bolshoydrug1/Kvadro_CTRL_hw/(list of files, drawings)

Other design files:
freerouting.dsn
