bolshoydrug1/Kvadro_CTRL_hw/Magister_work_v1.kicad_pcb

## KiCad design Magister_work_v1.kicad_pcb (2026-08-19)

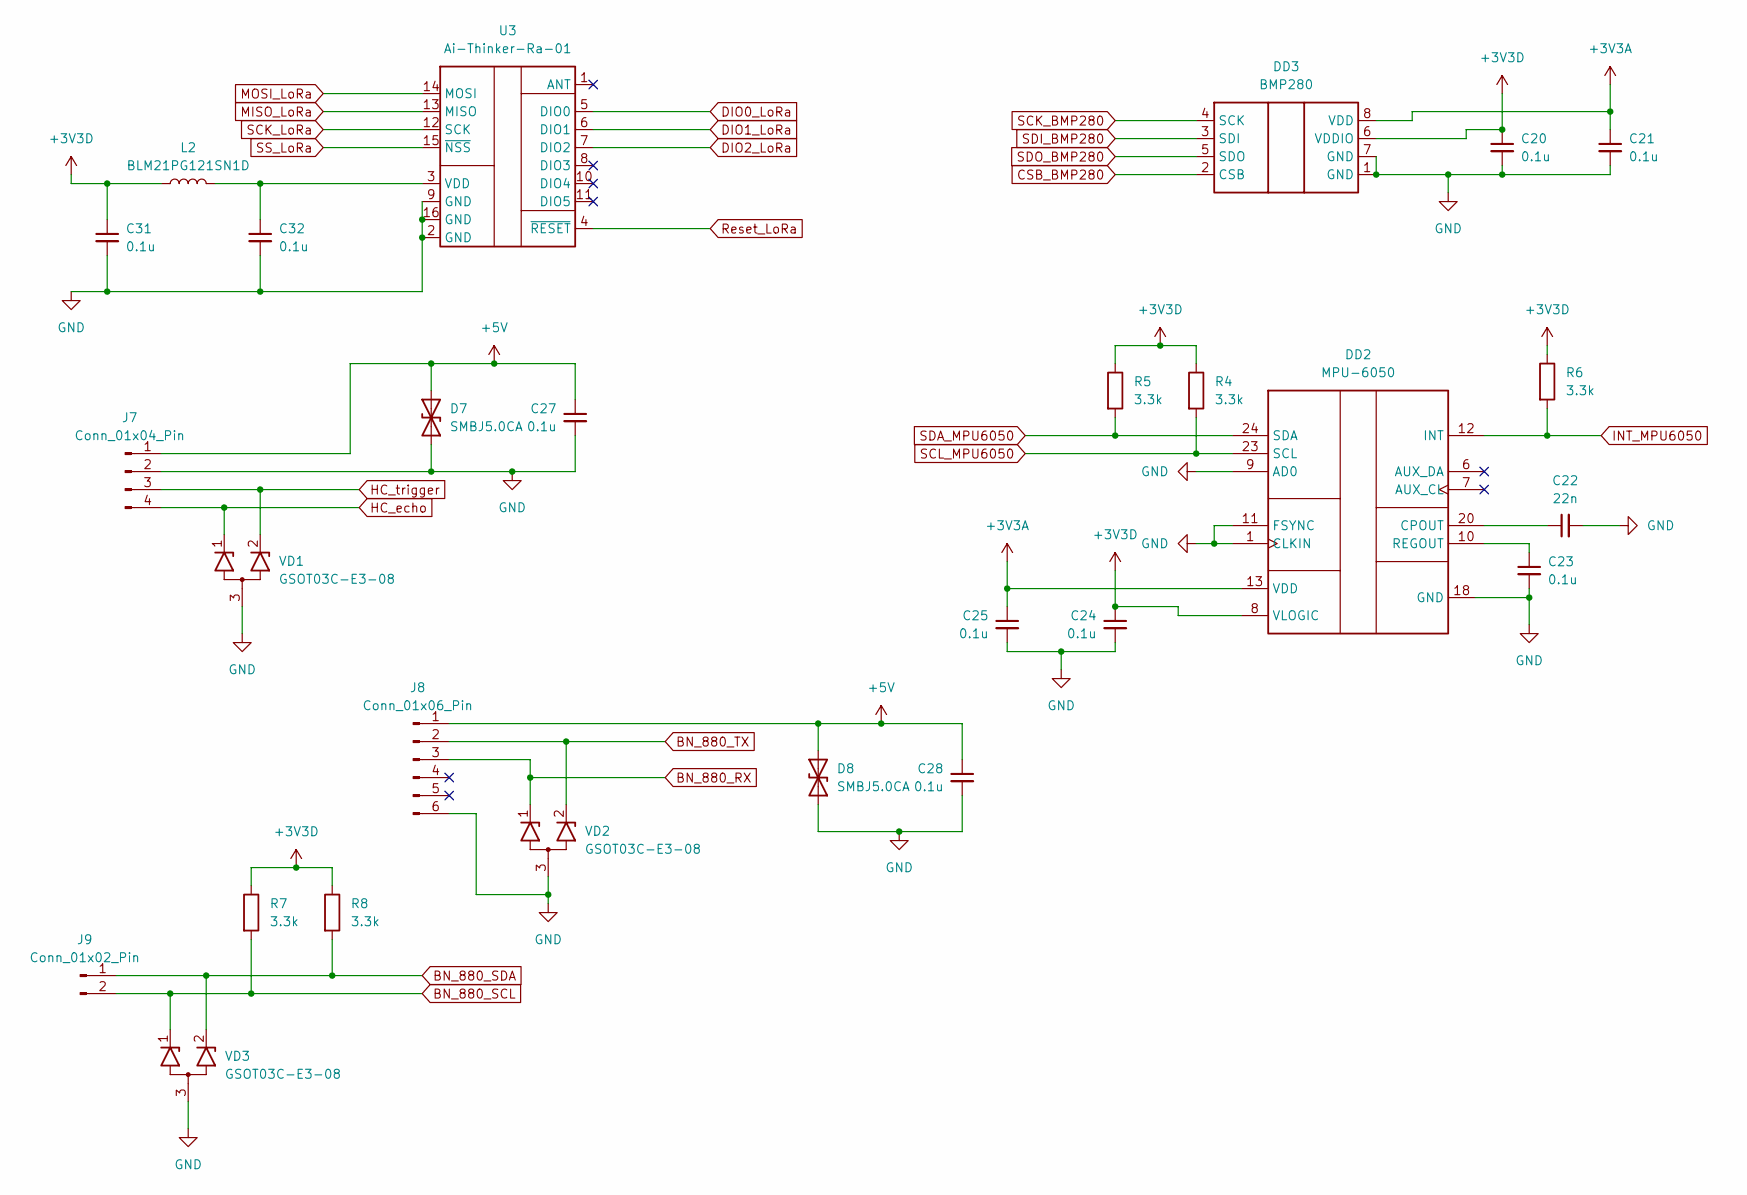
[picture p1: schematic Sensors_1.kicad_sch]

Parts:
C20, C21, C23, C24, C25, C27, C28, C31, C32: 0.1u; C_0805_2012Metric_Pad1.18x1.45mm_HandSolder
C22: 22n; C_0805_2012Metric_Pad1.18x1.45mm_HandSolder
D7, D8: SMBJ5.0CA; D_SMB_Handsoldering
DD2: MPU-6050; InvenSense_QFN-24_4x4mm_P0.5mm
DD3: BMP280; Bosch_LGA-8_2x2.5mm_P0.65mm_ClockwisePinNumbering
J7: Conn_01x04_Pin; PinHeader_1x04_P2.54mm_Horizontal
J8: Conn_01x06_Pin; Hirose_DF13-06P-1.25DSA_1x06_P1.25mm_Vertical
J9: Conn_01x02_Pin; Hirose_DF13-02P-1.25DSA_1x02_P1.25mm_Vertical
L2: BLM21PG121SN1D; L_0805_2012Metric_Pad1.05x1.20mm_HandSolder
R4, R5, R6, R7, R8: 3.3k; R_0805_2012Metric_Pad1.20x1.40mm_HandSolder
U3: Ai-Thinker-Ra-01; Ai-Thinker-Ra-01-LoRa
VD1, VD2, VD3: GSOT03C-E3-08; SOT-23_Handsoldering

Connections:
+3V3A: C21.1, C25.1, DD2.13 (VDD), DD3.8 (VDD); also elsewhere on the board
+3V3D: C20.1, C24.1, C31.1, DD2.8 (VLOGIC), DD3.6 (VDDIO), L2.1, R4.1, R5.1, R6.1, R7.1, R8.1; also elsewhere on the board
+5V: C27.1, C28.1, D7.2 (A2), D8.2 (A2), J7.1, J8.1; also elsewhere on the board
BN_880_RX: J8.3, VD2.1 (K1); also elsewhere on the board
BN_880_SCL: J9.2, R7.2, VD3.1 (K1); also elsewhere on the board
BN_880_SDA: J9.1, R8.2, VD3.2 (K2); also elsewhere on the board
BN_880_TX: J8.2, VD2.2 (K2); also elsewhere on the board
CSB_BMP280: DD3.2 (CSB); also elsewhere on the board
DIO0_LoRa: U3.5 (DIO0); also elsewhere on the board
DIO1_LoRa: U3.6 (DIO1); also elsewhere on the board
DIO2_LoRa: U3.7 (DIO2); also elsewhere on the board
GND: C20.2, C21.2, C22.2, C23.2, C24.2, C25.2, C27.2, C28.2, C31.2, C32.2, D7.1 (A1), D8.1 (A1), DD2.1 (CLKIN), DD2.9 (AD0), DD2.11 (FSYNC), DD2.18 (GND), DD3.1 (GND), DD3.7 (GND), J7.2, J8.6, U3.2 (GND), U3.9 (GND), U3.16 (GND), VD1.3 (A), VD2.3 (A), VD3.3 (A); also elsewhere on the board
HC_echo: J7.4, VD1.1 (K1); also elsewhere on the board
HC_trigger: J7.3, VD1.2 (K2); also elsewhere on the board
INT_MPU6050: DD2.12 (INT), R6.2; also elsewhere on the board
MISO_LoRa: U3.13 (MISO); also elsewhere on the board
MOSI_LoRa: U3.14 (MOSI); also elsewhere on the board
unnamed: C22.1, DD2.20 (CPOUT)
unnamed: C23.1, DD2.10 (REGOUT)
unnamed: C32.1, L2.2, U3.3 (VDD)
Reset_LoRa: U3.4 (~RESET); also elsewhere on the board
SCK_BMP280: DD3.4 (SCK); also elsewhere on the board
SCK_LoRa: U3.12 (SCK); also elsewhere on the board
SCL_MPU6050: DD2.23 (SCL), R4.2; also elsewhere on the board
SDA_MPU6050: DD2.24 (SDA), R5.2; also elsewhere on the board
SDI_BMP280: DD3.3 (SDI); also elsewhere on the board
SDO_BMP280: DD3.5 (SDO); also elsewhere on the board
SS_LoRa: U3.15 (~NSS); also elsewhere on the board

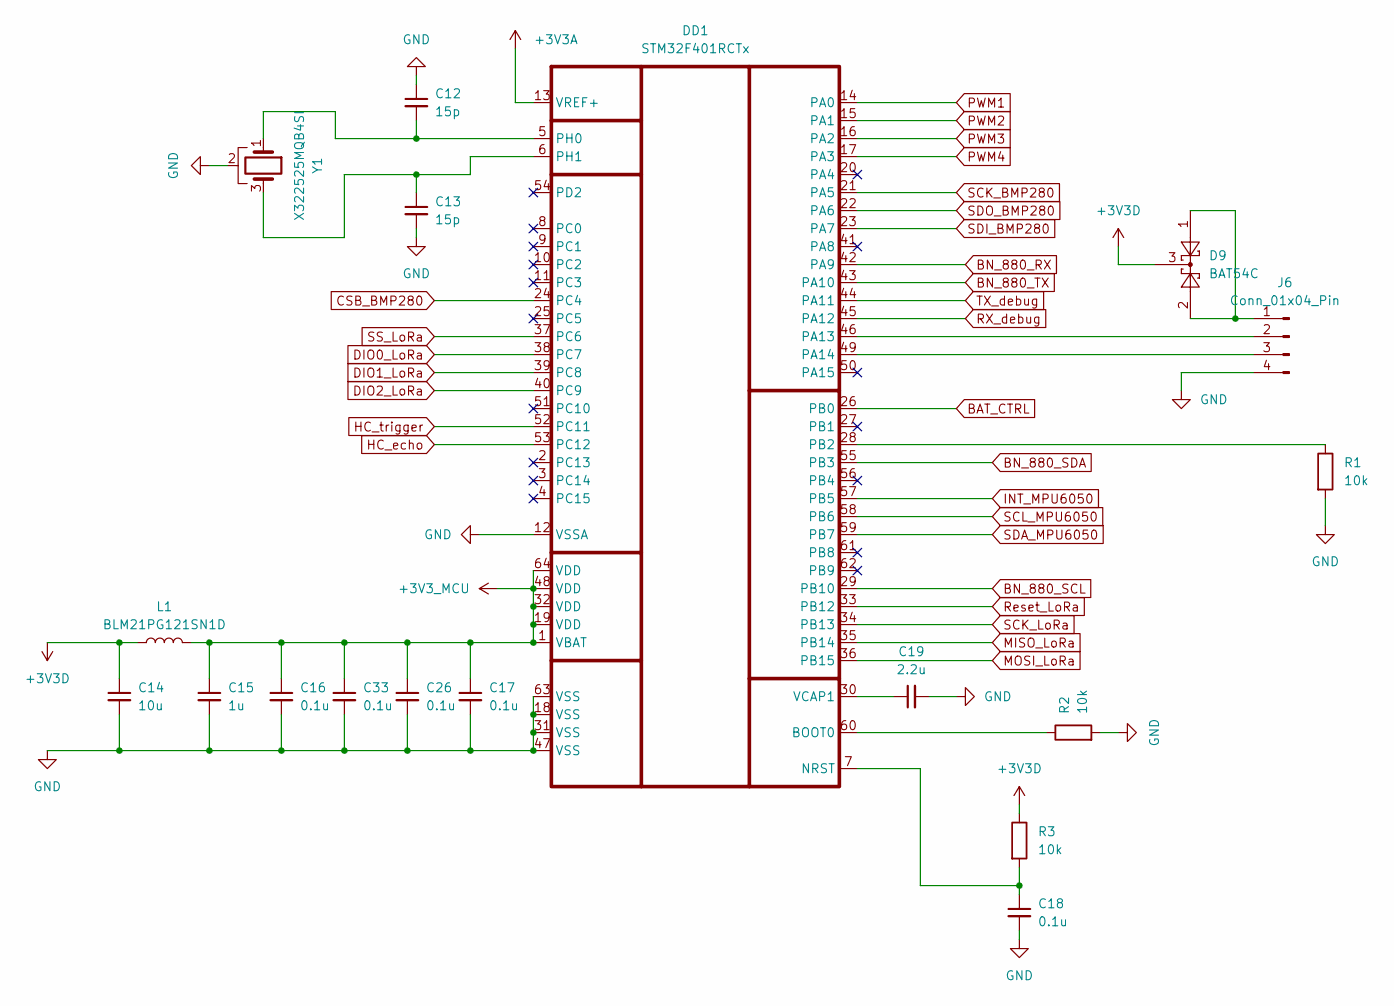
[picture p2: schematic STMF401.kicad_sch]

Parts:
C12, C13: 15p; C_0805_2012Metric_Pad1.18x1.45mm_HandSolder
C14: 10u; C_0805_2012Metric_Pad1.18x1.45mm_HandSolder
C15: 1u; C_0805_2012Metric_Pad1.18x1.45mm_HandSolder
C16, C17, C18, C26, C33: 0.1u; C_0805_2012Metric_Pad1.18x1.45mm_HandSolder
C19: 2.2u; C_0805_2012Metric_Pad1.18x1.45mm_HandSolder
D9: BAT54C; SOT-23_Handsoldering
DD1: STM32F401RCTx; LQFP-64_10x10mm_P0.5mm
J6: Conn_01x04_Pin; PinSocket_1x04_P2.54mm_Vertical
L1: BLM21PG121SN1D; L_0805_2012Metric_Pad1.05x1.20mm_HandSolder
R1, R2, R3: 10k; R_0805_2012Metric_Pad1.20x1.40mm_HandSolder
Y1: X322525MQB4SI; Oscillator_SMD_Abracon_ASE-4Pin_3.2x2.5mm

Connections:
+3V3A: DD1.13 (VREF+); also elsewhere on the board
+3V3D: C14.1, D9.3, L1.1, R3.1; also elsewhere on the board
+3V3_MCU: C15.1, C16.1, C17.1, C26.1, C33.1, DD1.1 (VBAT), DD1.19 (VDD), DD1.32 (VDD), DD1.48 (VDD), DD1.64 (VDD), L1.2
BAT_CTRL: DD1.26 (PB0); also elsewhere on the board
BN_880_RX: DD1.42 (PA9); also elsewhere on the board
BN_880_SCL: DD1.29 (PB10); also elsewhere on the board
BN_880_SDA: DD1.55 (PB3); also elsewhere on the board
BN_880_TX: DD1.43 (PA10); also elsewhere on the board
CSB_BMP280: DD1.24 (PC4); also elsewhere on the board
DIO0_LoRa: DD1.38 (PC7); also elsewhere on the board
DIO1_LoRa: DD1.39 (PC8); also elsewhere on the board
DIO2_LoRa: DD1.40 (PC9); also elsewhere on the board
GND: C12.1, C13.2, C14.2, C15.2, C16.2, C17.2, C18.2, C19.2, C26.2, C33.2, DD1.12 (VSSA), DD1.18 (VSS), DD1.31 (VSS), DD1.47 (VSS), DD1.63 (VSS), J6.4, R1.2, R2.2, Y1.2 (GND), Y1.4 (GND); also elsewhere on the board
HC_echo: DD1.53 (PC12); also elsewhere on the board
HC_trigger: DD1.52 (PC11); also elsewhere on the board
INT_MPU6050: DD1.57 (PB5); also elsewhere on the board
MISO_LoRa: DD1.35 (PB14); also elsewhere on the board
MOSI_LoRa: DD1.36 (PB15); also elsewhere on the board
unnamed: DD1.60 (BOOT0), R2.1
unnamed: C18.1, DD1.7 (NRST), R3.2
unnamed: DD1.46 (PA13), J6.2
unnamed: DD1.49 (PA14), J6.3
unnamed: DD1.28 (PB2), R1.1
unnamed: C12.2, DD1.5 (PH0), Y1.1 (OSC)
unnamed: C13.1, DD1.6 (PH1), Y1.3 (OSC)
unnamed: C19.1, DD1.30 (VCAP1)
unnamed: D9.1, D9.2, J6.1
PWM1: DD1.14 (PA0); also elsewhere on the board
PWM2: DD1.15 (PA1); also elsewhere on the board
PWM3: DD1.16 (PA2); also elsewhere on the board
PWM4: DD1.17 (PA3); also elsewhere on the board
RX_debug: DD1.45 (PA12); also elsewhere on the board
Reset_LoRa: DD1.33 (PB12); also elsewhere on the board
SCK_BMP280: DD1.21 (PA5); also elsewhere on the board
SCK_LoRa: DD1.34 (PB13); also elsewhere on the board
SCL_MPU6050: DD1.58 (PB6); also elsewhere on the board
SDA_MPU6050: DD1.59 (PB7); also elsewhere on the board
SDI_BMP280: DD1.23 (PA7); also elsewhere on the board
SDO_BMP280: DD1.22 (PA6); also elsewhere on the board
SS_LoRa: DD1.37 (PC6); also elsewhere on the board
TX_debug: DD1.44 (PA11); also elsewhere on the board

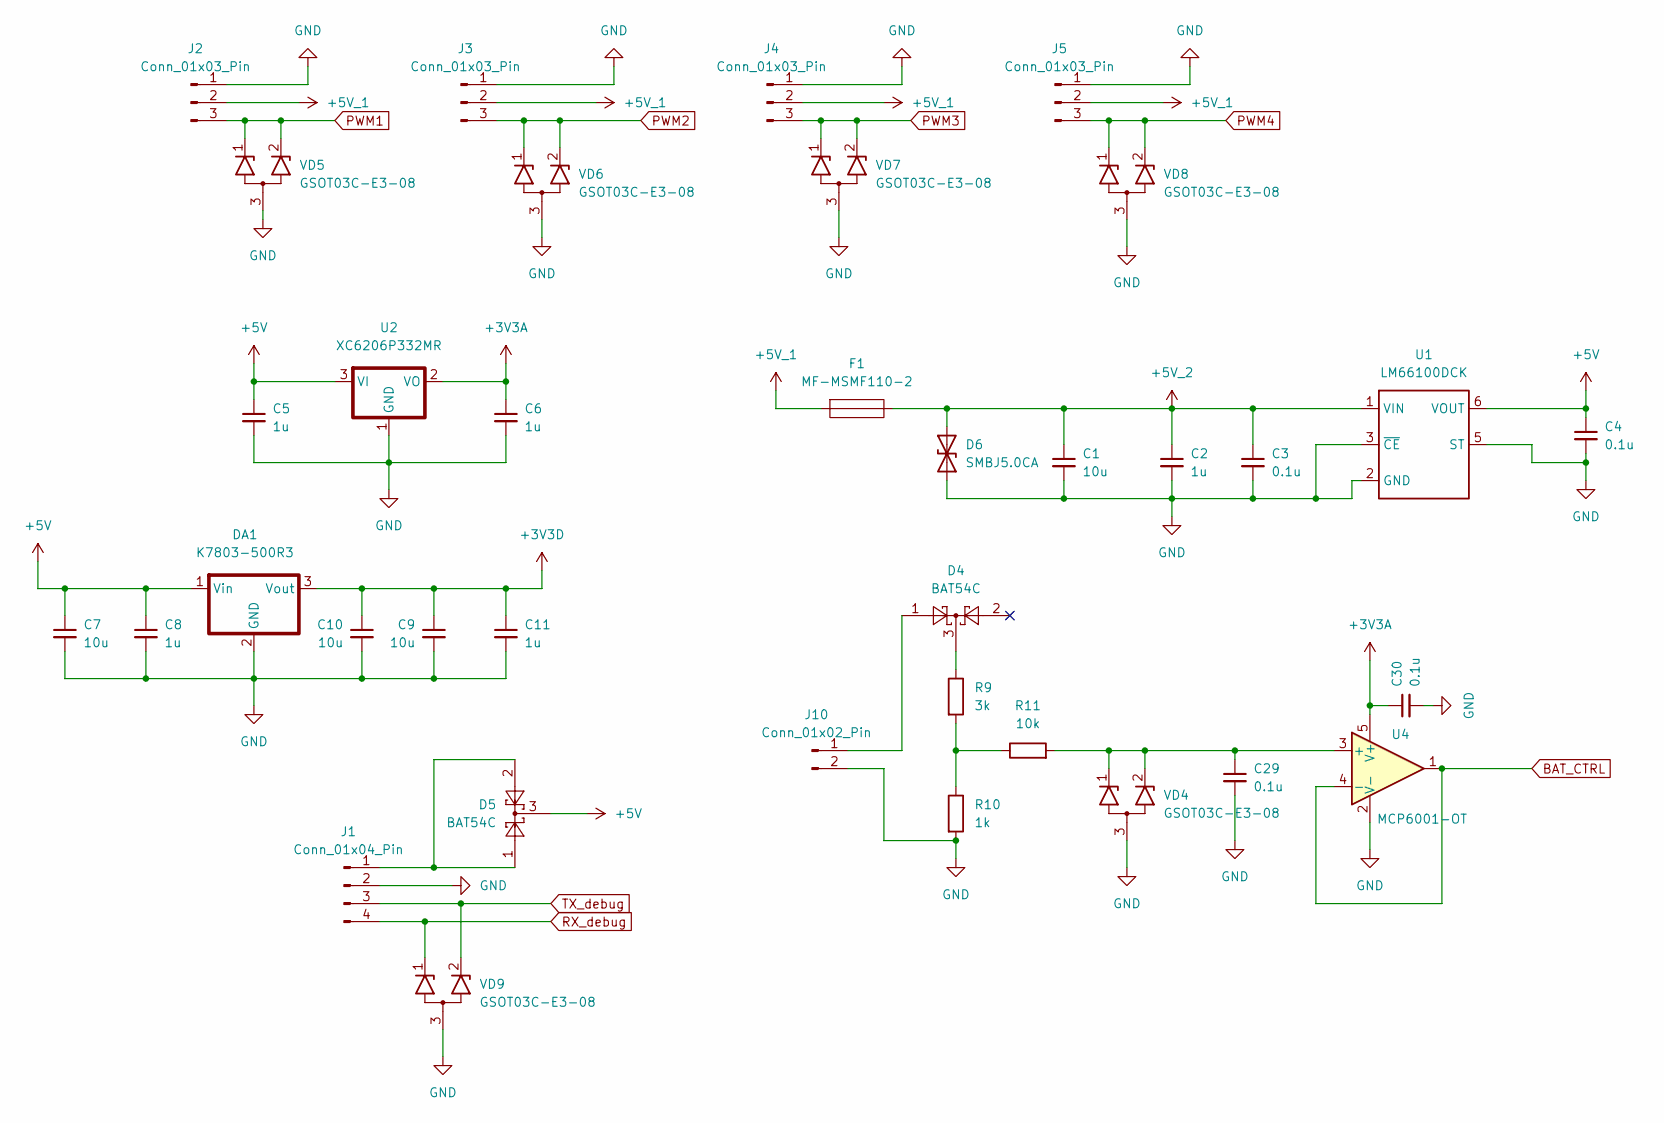
[picture p3: schematic PWR.kicad_sch]

Parts:
C1, C7, C9, C10: 10u; C_0805_2012Metric_Pad1.18x1.45mm_HandSolder
C2, C5, C6, C8, C11: 1u; C_0805_2012Metric_Pad1.18x1.45mm_HandSolder
C3, C4, C29, C30: 0.1u; C_0805_2012Metric_Pad1.18x1.45mm_HandSolder
D4, D5: BAT54C; SOT-23_Handsoldering
D6: SMBJ5.0CA; D_SMB_Handsoldering
DA1: K7803-500R3; SIP3_11.6x8.5mm
F1: MF-MSMF110-2; Fuse_1812_4532Metric_Pad1.30x3.40mm_HandSolder
J1: Conn_01x04_Pin; PinSocket_1x04_P2.54mm_Vertical
J2, J3, J4, J5: Conn_01x03_Pin; PinHeader_1x03_P2.54mm_Horizontal
J10: Conn_01x02_Pin; Hirose_DF13-02P-1.25DSA_1x02_P1.25mm_Vertical
R9: 3k; R_0805_2012Metric_Pad1.20x1.40mm_HandSolder
R10: 1k; R_0805_2012Metric_Pad1.20x1.40mm_HandSolder
R11: 10k; R_0805_2012Metric_Pad1.20x1.40mm_HandSolder
U1: LM66100DCK; SOT-363_SC-70-6
U2: XC6206P332MR; SOT-23_Handsoldering
U4: MCP6001-OT; SOT-23-5_HandSoldering
VD4, VD5, VD6, VD7, VD8, VD9: GSOT03C-E3-08; SOT-23_Handsoldering

Connections:
+3V3A: C6.1, C30.1, U2.2 (VO), U4.5 (V+); also elsewhere on the board
+3V3D: C9.1, C10.1, C11.1, DA1.3 (Vout); also elsewhere on the board
+5V: C4.1, C5.1, C7.1, C8.1, D5.3, DA1.1 (Vin), U1.6 (VOUT), U2.3 (VI); also elsewhere on the board
+5V_1: F1.1 (A1), J2.2, J3.2, J4.2, J5.2
+5V_2: C1.1, C2.1, C3.1, D6.2 (A2), F1.2 (A2), U1.1 (VIN)
BAT_CTRL: U4.1, U4.4 (-); also elsewhere on the board
GND: C1.2, C2.2, C3.2, C4.2, C5.2, C6.2, C7.2, C8.2, C9.2, C10.2, C11.2, C29.2, C30.2, D6.1 (A1), DA1.2 (GND), J1.2, J2.1, J3.1, J4.1, J5.1, J10.2, R10.2, U1.2 (GND), U1.3 (~CE), U1.5 (ST), U2.1 (GND), U4.2 (V-), VD4.3 (A), VD5.3 (A), VD6.3 (A), VD7.3 (A), VD8.3 (A), VD9.3 (A); also elsewhere on the board
unnamed: D4.3, R9.1
unnamed: D5.1, D5.2, J1.1
unnamed: D4.1, J10.1
unnamed: R9.2, R10.1, R11.1
unnamed: C29.1, R11.2, U4.3 (+), VD4.1 (K1), VD4.2 (K2)
PWM1: J2.3, VD5.1 (K1), VD5.2 (K2); also elsewhere on the board
PWM2: J3.3, VD6.1 (K1), VD6.2 (K2); also elsewhere on the board
PWM3: J4.3, VD7.1 (K1), VD7.2 (K2); also elsewhere on the board
PWM4: J5.3, VD8.1 (K1), VD8.2 (K2); also elsewhere on the board
RX_debug: J1.4, VD9.1 (K1); also elsewhere on the board
TX_debug: J1.3, VD9.2 (K2); also elsewhere on the board

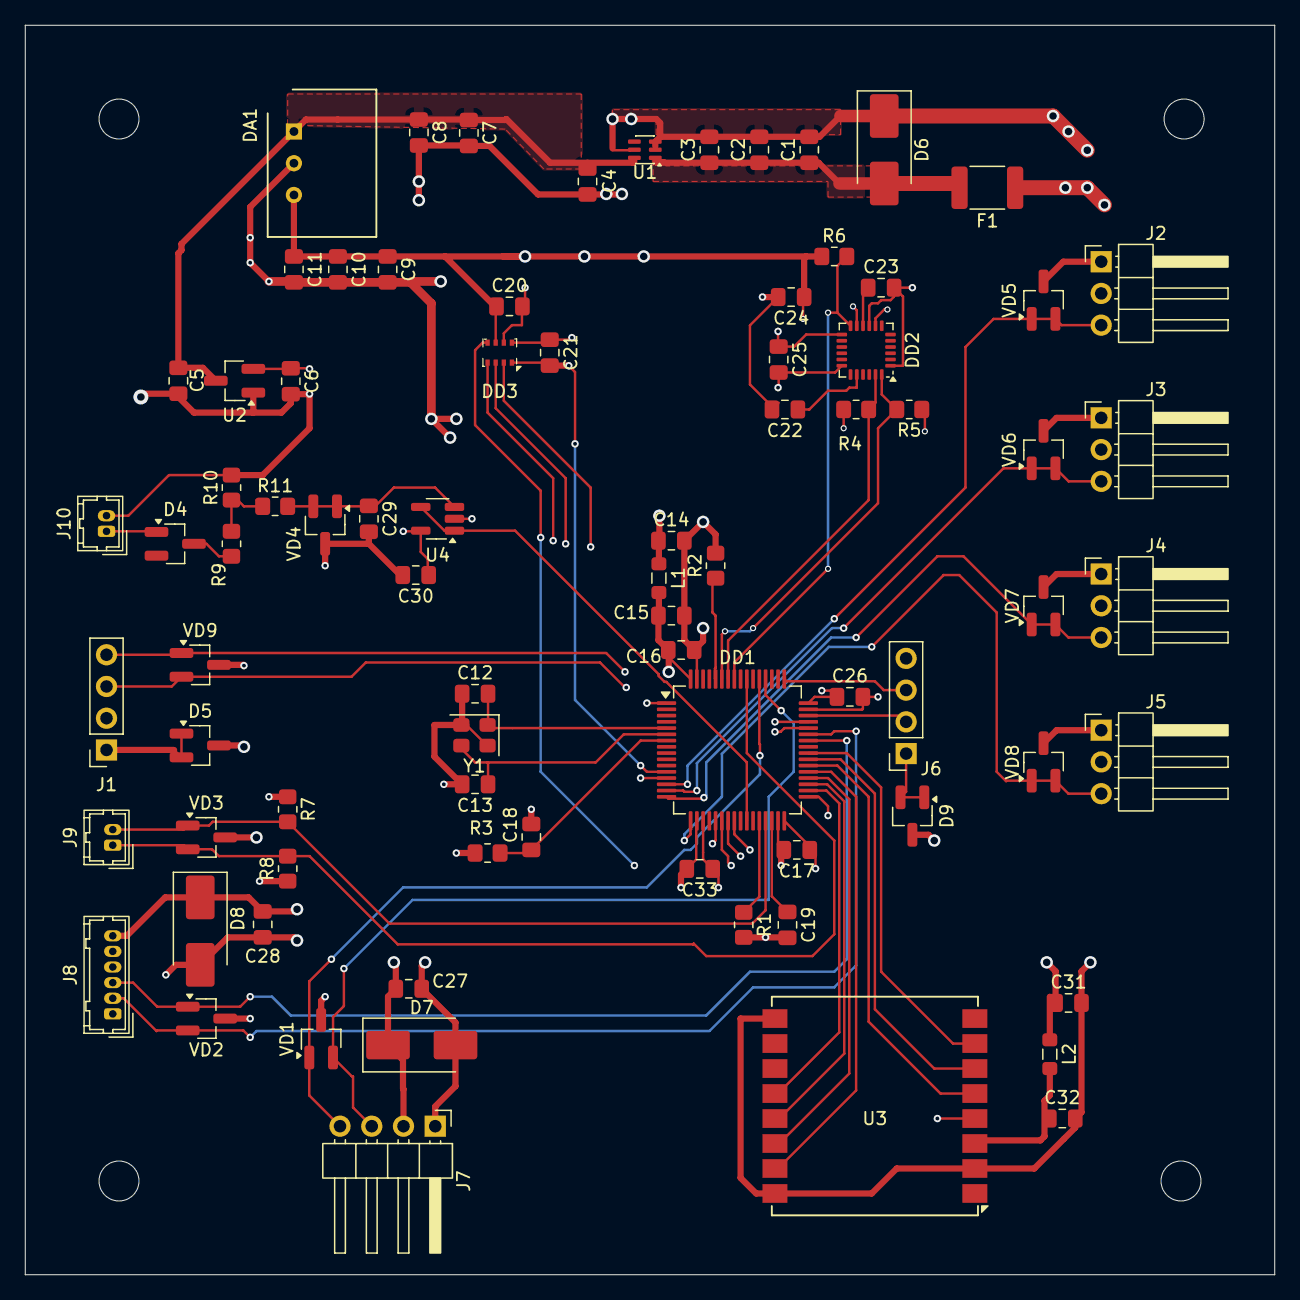
[picture p4: board Magister_work_v1.kicad_pcb from above]

Board: 4 copper layers, 100.0 x 100.0 mm, 81 parts (0 on the bottom side), 52 nets.
