bolshoydrug1/Kvadro_CTRL_hw/(commit log)

2026-05-18 feat: added scheme of power and MCU
    [Magister_work_v1.kicad_pcb, Magister_work_v1.kicad_sch, PWR.kicad_sch, STMF401.kicad_sch, Sensors_1.kicad_sch, untitled.kicad_sch]
2026-05-19 feat: added connection for sensors
    [PWR.kicad_sch, Sensors_1.kicad_sch]
2026-05-22 feat: firs complete version schemattic
    [Magister_work_v1.kicad_pcb, PWR.kicad_sch, STMF401.kicad_sch, Sensors_1.kicad_sch]
2026-05-23 feat: added UART for debug
    [PWR.kicad_sch]
2026-05-23 feat: Added part of the connections (digital data lines) of the microcontroller
    [STMF401.kicad_sch, Sensors_1.kicad_sch]
2026-05-24 feat: added all connection for MCU
    [Magister_work_v1.kicad_pcb, STMF401.kicad_sch]
2026-05-28 feat: complete schematic, and start PCB
    [Magister_work_v1.kicad_pcb, PWR.kicad_sch, STMF401.kicad_sch, Sensors_1.kicad_sch]
2026-05-29 feat: first version pf PCB without data and power line
    [Magister_work_v1.kicad_pcb]
2026-05-30 feat: start PCB trace
    [Magister_work_v1.kicad_pcb, PWR.kicad_sch]
2026-05-30 feat: replace MPU6050 perefery
    [Magister_work_v1.kicad_pcb]
2026-05-31 feat: added line for 5V power
    [Magister_work_v1.csv, Magister_work_v1.kicad_pcb, freerouting.dsn, temp-freerouting.dsn]
2026-06-01 feat: added 3.3V line Power for Lora and sensors
    [Magister_work_v1.kicad_pcb]
2026-06-02 feat: added power lines for MCU
    [Magister_work_v1.kicad_pcb]
2026-06-02 fix: fix bug with locked hole
    [Magister_work_v1.kicad_pcb, temp-freerouting.dsn]
2026-06-04 feat: added MPU and PWM line
    [Magister_work_v1.kicad_pcb]
2026-06-05 feat: added mani lines for GND
    [Magister_work_v1.kicad_pcb, STMF401.kicad_sch, Sensors_1.kicad_sch]
2026-06-06 feat: add zone for 3v3D power
    [Magister_work_v1.kicad_pcb]
2026-06-07 feat: added zone for GND and 3v3A
    [Magister_work_v1.kicad_pcb]
2026-06-07 feat: first version complitr PCB
    [Magister_work_v1.kicad_pcb]
2026-06-07 feat: added gbr files
    [Magister_work_v1-B_Cu.gbr, Magister_work_v1-B_Mask.gbr, Magister_work_v1-B_Paste.gbr, Magister_work_v1-B_Silkscreen.gbr, Magister_work_v1-Edge_Cuts.gbr, Magister_work_v1-F_Cu.gbr, Magister_work_v1-F_Mask.gbr, Magister_work_v1-F_Paste.gbr]
2026-08-19 feat: первая версий, которая ушла в производство
    [Magister_work_v1.kicad_pcb]
